hoglet67/Beeb1MHzBusFpga/kicad/v2/BusAdapter.pdf

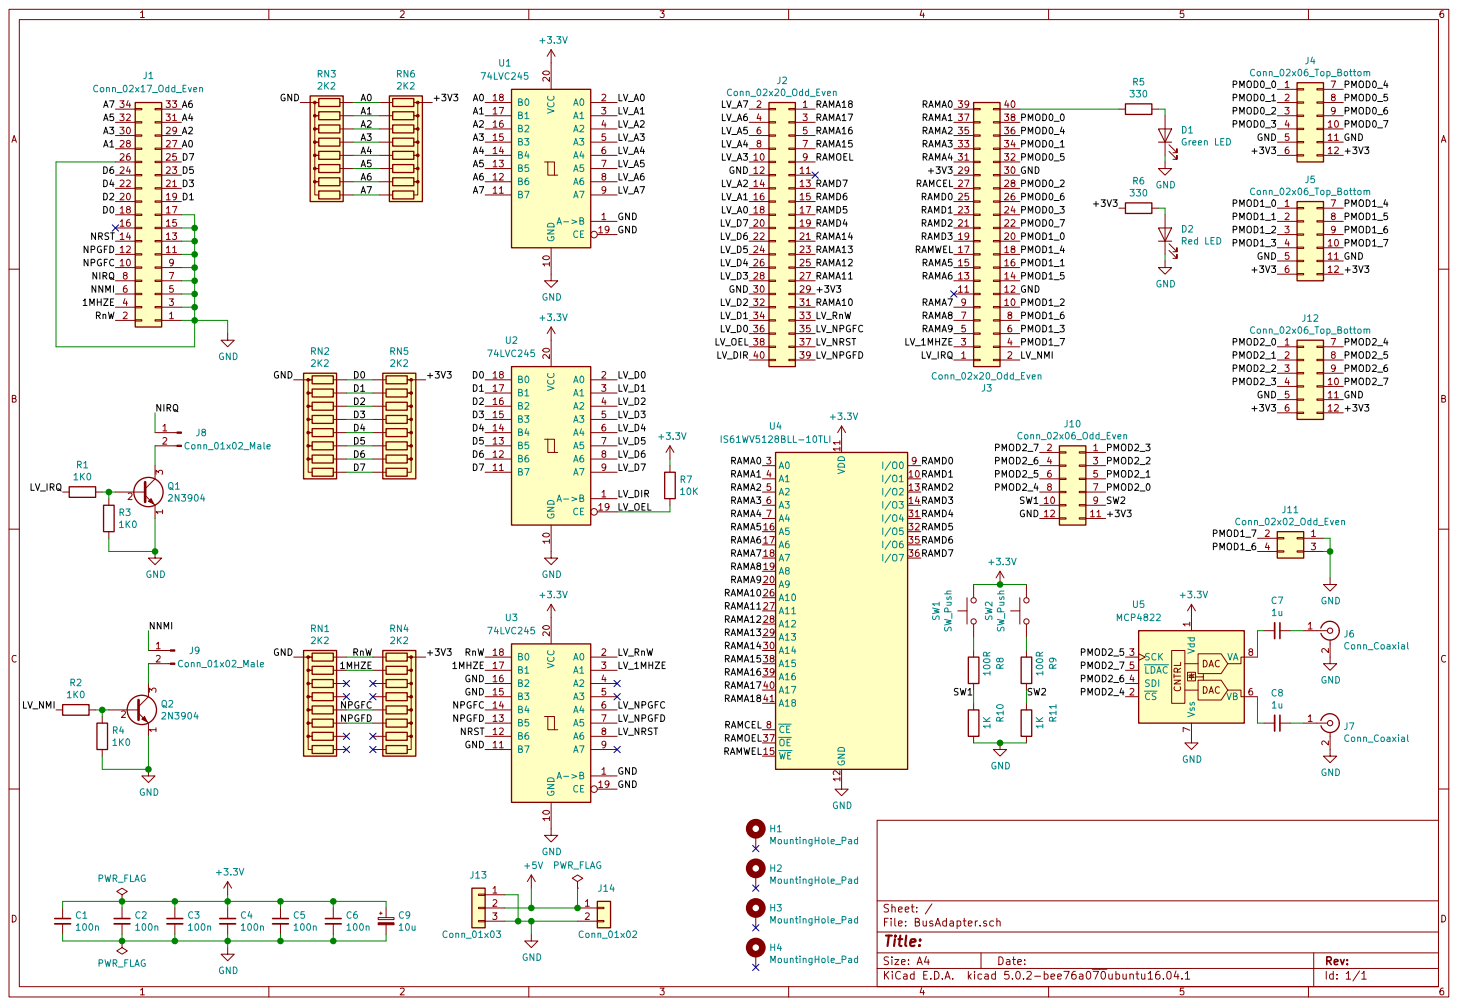
[picture p2: page 1]

File: BusAdapter.sch Sheet: /
Id: 1/1 Title:
