hoglet67/Beeb1MHzBusFpga/v1/Music5000.sch

## KiCad design v1/Music5000.sch (2019-03-05)

Schematic: Music5000.sch

Parts:
C1, C2, C3, C4, C5: 100n; C_Axial_L5.1mm_D3.1mm_P10.00mm_Horizontal
C6: 10u; CP_Radial_D5.0mm_P2.50mm
C7, C8: 1u; C_Rect_L7.2mm_W5.5mm_P5.00mm_FKS2_FKP2_MKS2_MKP2
D1, D2: LED; LED_D3.0mm
H1, H2, H3, H4: MountingHole_Pad; MountingHole_3.2mm_M3_Pad
J1: Conn_02x17_Odd_Even; IDC-Header_2x17_P2.54mm_Horizontal_Lock
J2, J3: Conn_02x20_Odd_Even; PinSocket_2x20_P2.54mm_Vertical
J4, J5: Conn_02x06_Top_Bottom; PinSocket_2x06_P2.54mm_Horizontal
J6, J7: Conn_Coaxial; phono
J8, J9: Conn_01x02_Male; PinHeader_1x02_P2.54mm_Vertical
Q1, Q2: 2N3904; TO-92_HandSolder
R1, R2, R3, R4, R8, R9: 1K0; R_Axial_DIN0207_L6.3mm_D2.5mm_P10.16mm_Horizontal
R5, R6: 330; R_Axial_DIN0207_L6.3mm_D2.5mm_P10.16mm_Horizontal
R7: 10K; R_Axial_DIN0207_L6.3mm_D2.5mm_P10.16mm_Horizontal
RN1, RN2, RN3, RN4, RN5, RN6: R_Network08; R_Array_SIP9
SW1, SW2: SW_Push; SW_PUSH_6mm_H5mm
U1, U2, U3: 74LVC245; DIP-20_W7.62mm_Socket
U4: IDT 71V424S12; SOJ-36_10.16x23.49mm_P1.27mm
U5: MCP4822; DIP-8_W7.62mm_Socket
