hoglet67/Beeb1MHzBusFpga/life/src/life.v

// The number of cascaded life pipeline stages. Above 8 stages there
// are issues on the vertical boundary because only column is prefetched
`ifndef STAGES
 `define STAGES          8
`endif

`define VERSION_MAJ 8'h00     // Major version is updated when ever there are incompatible register changes
`define VERSION_MIN 8'h00     // Minor version is updated when ever there are other changes

`define MAGIC_HI    8'h19     // Used to identify the presence of the hardware
`define MAGIC_LO    8'h67     // Used to identify the presence of the hardware

//`define VGA_800_600
//`define VGA_1024_768
//`define VGA_1280_720
//`define VGA_1280_768
//`define VGA_1280_1024
//`define VGA_1600_1200
//`define VGA_1920_1080
//`define VGA_1920_1200

// Default to 1600x1200 if nothing already specified
`ifndef VGA_800_600
 `ifndef VGA_1024_768
  `ifndef VGA_1280_720
   `ifndef VGA_1280_768
    `ifndef VGA_1280_1024
     `ifndef VGA_1600_1200
      `ifndef VGA_1920_1080
       `ifndef VGA_1920_1200
        `define VGA_1600_1200
       `endif
      `endif
     `endif
    `endif
   `endif
  `endif
 `endif
`endif

module life (
             // System oscillator
             clk50,
             // BBC 1MHZ Bus
             clke,
             rnw,
             rst_n,
             pgfc_n,
             pgfd_n,
             bus_addr,
             bus_data,
             bus_data_dir,
             bus_data_oel,
             nmi,
             irq,
             // RAM
             ram_addr,
             ram_data,
             ram_cel,
             ram_oel,
             ram_wel,
             // Misc
             pmod0,
             pmod1,
             pmod2,
             sw1,
             sw2,
             led
             );

   // System oscillator
   input             clk50;
   // BBC 1MHZ Bus
   input             clke;
   input             rnw;
   input             rst_n;
   input             pgfc_n;
   input             pgfd_n;
   input [7:0]       bus_addr;
   inout [7:0]       bus_data;
   output            bus_data_dir;
   output            bus_data_oel;
   output            nmi;
   output            irq;
   // RAM
   output reg [18:0] ram_addr;
   inout [7:0]       ram_data;
   output reg        ram_cel;
   output reg        ram_oel;
   output reg        ram_wel;
   // Misc
   output [7:0]      pmod0;
   output [7:0]      pmod1;
   inout  [7:0]      pmod2;
   input             sw1;
   input             sw2;
   output            led;

`include "resolutions.v"

   // Number of cascaded life pipeline stages
   localparam STAGES        = `STAGES;

   // Numver of address bits used for playfield pointers
   localparam ASIZE         = 19;

   // Number of rows in life playfield
   localparam NR            = V_ACTIVE;

   // Total number of rows on the display
   localparam TR            = V_TOTAL;

   // Number of (byte) cols in life playfield
   localparam NC            = H_ACTIVE / 8;

   // Total number of (byte) cols on the display
   localparam TC            = H_TOTAL / 8;

   // Video Pipeline Delay (inc SRAM) in clk_pixel cycles
   localparam VPD           = 2;

   // Scaler fractional bits
   localparam SFB           = 2;

   // Life Pipeline Delay (in bytes)
   localparam LPD           = 3;

   // Fixed point versions of H_ACTIVE and V_ACTIVE
   localparam H_ACTIVE_FP   = {H_ACTIVE, {SFB{1'b0}}};
   localparam V_ACTIVE_FP   = {V_ACTIVE, {SFB{1'b0}}};

   // Size of the BRAM used for the scaler (in units of 2 pixels)
   localparam BRAM_SIZE     = 262144;

   // Clocks
   wire                clk0;
   wire                clk1;
   wire                clk2;
   wire                locked1;
   wire                clk_pixel;
   wire                clk_pixel_n;

   // Video Timing
   reg [11:0]          h_counter_next = 0;
   reg [11:0]          h_counter = 0;
   reg [10:0]          v_counter_next = 0;
   reg [10:0]          v_counter = 0;
   reg                 last_vsync1 = 0;
   reg                 last_vsync2 = 0;
   reg                 active = 0;
   reg                 hsync = 0;
   reg                 vsync = 0;
   reg                 blank = 0;
   reg                 border = 0;
   reg [VPD:0]         hsync0 = 0; // +1 delay, to compensate for the DDR registers on RGB
   reg [VPD:0]         vsync0 = 0; // +1 delay, to compensate for the DDR registers on RGB
   reg [VPD-1:0]       blank0 = 0;
   reg [VPD-1:0]       border0 = 0;
   reg [7:0]           mask = 0;

   // RGB
   reg [11:0]          rgb0 = 0;
   reg [11:0]          rgb1 = 0;
   wire [11:0]         rgb;
   wire [3:0]          red;
   wire [3:0]          green;
   wire [3:0]          blue;

   // Scaler Registers
   reg [2:0]           scaler_zoom = 0;                    // 0 = fully zoomed out (scaler bypassed)
   reg [10+SFB:0]      scaler_x_origin = H_ACTIVE_FP / 2;  // 11.2 fixed point
   reg [10+SFB:0]      scaler_y_origin = V_ACTIVE_FP / 2;  // 11.2 fixed point
   wire [10+SFB:0]     scaler_x_next;                      // 11.2 fixed point
   wire [10+SFB:0]     scaler_y_next;                      // 11.2 fixed point
   reg [7:0]           scaler_x_speed = 0;                 // 6.2 fixed point
   reg [7:0]           scaler_y_speed = 0;                 // 6.2 fixed point

   // Scaler parameters
   reg [8:0]           scaler_w = 0;
   reg [9:0]           scaler_h = 0;
   reg [11:0]          scaler_x_lo_tmp = 0;
   reg [11:0]          scaler_x_hi_tmp = 0;
   reg [11:0]          scaler_y_lo_tmp = 0;
   reg [11:0]          scaler_x_lo = 0;
   reg [11:0]          scaler_x_hi = 0;
   reg [11:0]          scaler_y_lo = 0;
   reg [3:0]           scaler_inc_x_mask = 0;
   reg [3:0]           scaler_inc_y_mask = 1; // To prevent Xilinx warning
   reg [10:0]          scaler_y_offset = 0;

   // Scaler write pipeline
   reg                 active0 = 0;
   reg                 active1 = 0;
   reg                 active2 = 0;
   reg [9:0]           scaler_y_count0 = 0;
   reg                 scaler_rst0 = 0;
   reg                 scaler_rst1 = 0;
   reg                 scaler_x_in_range0 = 0;
   reg                 scaler_wr1 = 0;
   reg                 scaler_wr2 = 0;
   reg                 scaler_wr3 = 0;
   reg [1:0]           scaler_bdr0 = 0;
   reg [1:0]           scaler_bdr1 = 0;
   reg [1:0]           scaler_bdr2 = 0;
   reg [1:0]           scaler_odd_din3 = 0;
   reg [1:0]           scaler_eve_din3 = 0;

   reg [8:0]           scaler_wr_addr_x2 = 0;
   reg [17:0]          scaler_wr_addr_y2 = 0;
   reg [17:0]          scaler_wr_addr3 = 0;
   reg                 scaler_din_last = 0;

   // Scaler RAM
   reg [1:0]           scaler_ram[0:BRAM_SIZE - 1];
   reg                 scaler_bank = 0;

   // Scaler read pipeline
   reg [17:0]          scaler_rd_addr_x = 0;
   reg [17:0]          scaler_rd_addr_y = 0;
   reg [17:0]          scaler_rd_addr = 0;
   reg                 scaler_rd_rst_x = 0;
   reg                 scaler_rd_rst_y = 0;
   reg                 scaler_rd_inc_x = 0;
   reg                 scaler_rd_inc_y = 0;
   reg                 scaler_rd_active = 0;
   reg                 scaler_pix_sel0 = 0;
   reg                 scaler_pix_sel1 = 0;
   reg [1:0]           scaler_dout2 = 0;
   reg                 scaler_dout = 0;

   // Life Pipeline
   reg                 life_clken = 0;
   reg                 life_rd_active = 0;
   wire [ASIZE-1:0]    life_rd_addr;
   reg [7:0]           life_rd_data = 0;
   reg                 life_wr_active = 0;
   reg [ASIZE-1:0]     life_wr_addr = 0;
   wire [7:0]          life_wr_data;
   reg [ASIZE-1:0]     life_col_addr = 0;
   reg [ASIZE-1:0]     life_row_addr = 0;
   reg [7:0]           display_dout = 0;
   reg                 running = 0;
   reg                 life_bank = 0;

   // Memory Controller
   reg                 beeb_rd = 0;
   reg                 write_n = 0;
   reg [7:0]           ram_din = 0;

   // 1MHz Bus
   reg                 selected = 0;
   reg                 selected_rr = 0;
   wire                selected_reg = selected && !selected_rr;
   wire                selected_ram = selected &&  selected_rr;

   reg [ASIZE-1:0]     cpu_addr = 0;
   reg [7:0]           cpu_wr_data = 0;
   reg                 cpu_wr_pending = 0;
   reg                 cpu_wr_pending1 = 0;
   reg                 cpu_wr_pending2 = 0;
   reg [7:0]           cpu_rd_data = 0;
   reg                 cpu_rd_pending = 0;
   reg                 cpu_rd_pending1 = 0;
   reg                 cpu_rd_pending2 = 0;
   reg [7:0]           control = 8'h00;

   wire                ctrl_running     = control[7];
   wire                ctrl_mask        = control[6];
   wire                ctrl_clear       = control[5];
   wire                ctrl_border      = control[4];
   wire [1:0]          ctrl_clear_type  = control[1:0];

   reg [3:0]           ctrl_stage_enabled = 0;
   reg [4:0]           speed_bin = 0;
   reg [STAGES-1:1]    stage_enabled = 0;

   wire [7:0]          status = { running, vsync, 2'b00, ctrl_stage_enabled};

   wire [7:0]          width_div_8 = H_ACTIVE / 8;
   wire [7:0]          height_div_8 = V_ACTIVE / 8;

   reg [7:0]           clear_wr_data = 0;
   reg [30:0]          prbs0 = 31'h12345678; // pick different seeds at random
   reg [30:0]          prbs1 = 31'h49987ffe;
   reg [30:0]          prbs2 = 31'h2fe457aa;

   genvar              i;
   integer             s;

   reg [7:0]           cells8;
   reg [31:0]          cells_tmp;
   reg [31:0]          cells;
   reg [31:0]          gens;

   function [7:0] to_byte(input [31:0] i);
      to_byte = i[7:0];
   endfunction

   function [ASIZE-1:0] truncate_address(input [ASIZE:0] addr);
      truncate_address = addr[ASIZE-1:0];
   endfunction

   function [ASIZE-1:0] double_buffer_address(input bank, input [ASIZE-1:0] addr);
      // double buffer the first 1/16th of the RAM
      if (addr[ASIZE-1:ASIZE-4] == 0)
        double_buffer_address = {{4{bank}}, addr[ASIZE-5:0]};
      else
        double_buffer_address = addr;
   endfunction

   function [3:0] count_live_cells(input [7:0] d);
      count_live_cells = d[0] + d[1] + d[2] + d[3] + d[4] + d[5] + d[6] + d[7];
   endfunction

   // =================================================
   // Clock Generation
   // =================================================

   generate

      if (DCM_M2 > 0) begin
         DCM
           #(
             .CLKFX_MULTIPLY   (DCM_M),
             .CLKFX_DIVIDE     (DCM_D),
             .CLKIN_PERIOD     (20.000),
             .CLK_FEEDBACK     ("1X")
             )
         DCM1
           (
            .CLKIN            (clk50),
            .CLKFB            (clk0),
            .RST              (1'b0),
            .DSSEN            (1'b0),
            .PSINCDEC         (1'b0),
            .PSEN             (1'b0),
            .PSCLK            (1'b0),
            .CLKFX            (clk1),
            .CLKFX180         (),
            .CLKDV            (),
            .CLK2X            (),
            .CLK2X180         (),
            .CLK0             (clk0),
            .CLK90            (),
            .CLK180           (),
            .CLK270           (),
            .LOCKED           (locked1),
            .PSDONE           (),
            .STATUS           ()
            );

         DCM
           #(
             .CLKFX_MULTIPLY   (DCM_M2),
             .CLKFX_DIVIDE     (DCM_D2),
             .CLK_FEEDBACK     ("1X")
             )
         DCM2
           (
            .CLKIN            (clk1),
            .CLKFB            (clk2),
            .RST              (!locked1),
            .DSSEN            (1'b0),
            .PSINCDEC         (1'b0),
            .PSEN             (1'b0),
            .PSCLK            (1'b0),
            .CLKFX            (clk_pixel),
            .CLKFX180         (clk_pixel_n),
            .CLKDV            (),
            .CLK2X            (),
            .CLK2X180         (),
            .CLK0             (clk2),
            .CLK90            (),
            .CLK180           (),
            .CLK270           (),
            .LOCKED           (),
            .PSDONE           (),
            .STATUS           ()
            );

      end else begin

         DCM
           #(
             .CLKFX_MULTIPLY   (DCM_M),
             .CLKFX_DIVIDE     (DCM_D),
             .CLKIN_PERIOD     (20.000),
             .CLK_FEEDBACK     ("1X")
             )
         DCM1
           (
            .CLKIN            (clk50),
            .CLKFB            (clk0),
            .RST              (1'b0),
            .DSSEN            (1'b0),
            .PSINCDEC         (1'b0),
            .PSEN             (1'b0),
            .PSCLK            (1'b0),
            .CLKFX            (clk_pixel),
            .CLKFX180         (clk_pixel_n),
            .CLKDV            (),
            .CLK2X            (),
            .CLK2X180         (),
            .CLK0             (clk0),
            .CLK90            (),
            .CLK180           (),
            .CLK270           (),
            .LOCKED           (),
            .PSDONE           (),
            .STATUS           ()
            );

      end

   endgenerate

   // =================================================
   // Video Timing
   // =================================================

   always @(h_counter or v_counter) begin
      if (h_counter == H_TOTAL - 2) begin
         h_counter_next = 0;
         if (v_counter == V_TOTAL - 1)
           v_counter_next = 0;
         else
           v_counter_next = v_counter + 1'b1;
      end else begin
         v_counter_next = v_counter;
         // Step the h_counter in units of two pixels
         // (this means the LSB is not used, and will likely generate a warning)
         h_counter_next = h_counter + 2'b10;
      end
   end


   always @(posedge clk_pixel) begin
      h_counter <= h_counter_next;
      v_counter <= v_counter_next;

      // Active lags h_counter by one cycle
      active    <= h_counter_next < H_ACTIVE && v_counter_next < V_ACTIVE;

      // Skew the video control outputs by VPD clocks to compensate for the video pipeline delay
      // (the other way of doing this would be with pipeline registers)
      { hsync,  hsync0} <= {hsync0, (h_counter >= H_SYNC_START && h_counter < H_SYNC_END)};
      { vsync,  vsync0} <= {vsync0, (v_counter >= V_SYNC_START && v_counter < V_SYNC_END)};
      { blank,  blank0} <= {blank0, (h_counter >= H_ACTIVE || v_counter >= V_ACTIVE)};
      {border, border0} <= {border0, ((h_counter == 0 || h_counter == H_ACTIVE - 2) && (v_counter < V_ACTIVE)) ||
                                     ((v_counter == 0 || v_counter == V_ACTIVE - 1) && (h_counter < H_ACTIVE))};
   end

   // =================================================
   // Scaler (TODO: make this a seperate module)
   // =================================================


   always @(posedge clk_pixel) begin

      // No attempt had been made to control the latency through the scaler
      // so it's possible that the window will be a few pixels out horizonal in absolute accuracy

      // Example at 1600x1200:
      // Zoom = 0; window is 1600x1200 pixels (scaler bypassed)
      // Zoom = 1; window is 800x600 pixels
      // Zoom = 2; window is 400x300 pixels
      // Zoom = 3; window is 200x150 pixels
      // Zoom = 4; window is 100x75 pixels

      // *************************************************************************
      // *** Parameters (depend only on registers, so are considered fixed)
      // *************************************************************************

      case (scaler_zoom)
        3'b100:
          begin
             scaler_w <= H_ACTIVE / 32; // units of two-pixels
             scaler_h <= V_ACTIVE / 16;
             scaler_inc_x_mask <= 4'b1110;
             scaler_inc_y_mask <= 4'b1111;
             scaler_y_offset   <= 0;
          end
        3'b011:
          begin
             scaler_w <= H_ACTIVE / 16; // units of two-pixels
             scaler_h <= V_ACTIVE / 8;
             scaler_inc_x_mask <= 4'b0110;
             scaler_inc_y_mask <= 4'b0111;
             scaler_y_offset   <= 0;
          end
        3'b010:
          begin
             scaler_w <= H_ACTIVE / 8;  // units of two-pixels
             scaler_h <= V_ACTIVE / 4;
             scaler_inc_x_mask <= 4'b0010;
             scaler_inc_y_mask <= 4'b0011;
             scaler_y_offset   <= 0;
          end
        default:
          begin
             scaler_w <= H_ACTIVE / 4;  // units of two-pixels
             scaler_inc_x_mask <= 4'b0000;
             scaler_inc_y_mask <= 4'b0001;
             // At 1920x1200 this we need to reduce the number of active lines as there is insufficient RAM
             if (V_ACTIVE * H_ACTIVE / 8 < BRAM_SIZE) begin
               scaler_h <= V_ACTIVE / 2;
               scaler_y_offset <= 0;
             end else begin
               scaler_h <= BRAM_SIZE / (H_ACTIVE / 4);                          // 546 (rather than 600)
               scaler_y_offset <= (V_ACTIVE / 2) - BRAM_SIZE / (H_ACTIVE / 4);  // 54
             end
          end
      endcase

      // Calculate x,y of top left corner (only allow changes when scaler not running)
      if (scaler_y_count0 == 0) begin
         // Ignore the fractional bits
         scaler_x_lo_tmp <= scaler_x_origin[10+SFB:SFB] - scaler_w;
         scaler_x_hi_tmp <= scaler_x_origin[10+SFB:SFB] + scaler_w;
         scaler_y_lo_tmp <= scaler_y_origin[10+SFB:SFB] - scaler_h[9:1];
      end

      // Correct for wrapping
      if (scaler_x_lo_tmp < H_ACTIVE)
        scaler_x_lo <= scaler_x_lo_tmp;
      else
        scaler_x_lo <= scaler_x_lo_tmp + H_ACTIVE;
      if (scaler_x_hi_tmp <= H_ACTIVE)
        scaler_x_hi <= scaler_x_hi_tmp;
      else
        scaler_x_hi <= scaler_x_hi_tmp - H_ACTIVE;
      if (scaler_y_lo_tmp < V_ACTIVE)
        scaler_y_lo <= scaler_y_lo_tmp;
      else
        scaler_y_lo <= scaler_y_lo_tmp + V_ACTIVE;

      // *************************************************************************
      // *** Write Pipeline stage 0 (only this stage uses h_counter/v_counter and active)
      // *************************************************************************

      // Double buffer bank selection
      if (h_counter == 0 && v_counter == 0) begin
        if (scaler_zoom < 3'b010) begin
          scaler_bank <= 1'b0;
        end else begin
          scaler_bank <= !scaler_bank;
        end
      end

      // When to start capturing
      scaler_rst0 <= 1'b0;
      if (active) begin
         if (scaler_x_lo < scaler_x_hi) begin
            // The window doesn't cross the L/R boundary
            if (h_counter == {1'b0, scaler_x_lo[10:1], 1'b0}) begin
               if (v_counter == scaler_y_lo[10:0]) begin
                  scaler_rst0 <= 1'b1;
                  scaler_y_count0 <= scaler_h;
               end else if (|scaler_y_count0) begin
                  scaler_y_count0 <= scaler_y_count0 - 1'b1;
               end
            end
         end else begin
            if (h_counter == 0) begin
               if (v_counter == scaler_y_lo[10:0]) begin
                  scaler_rst0 <= 1'b1;
                  scaler_y_count0 <= scaler_h;
               end else if (|scaler_y_count0) begin
                  scaler_y_count0 <= scaler_y_count0 - 1'b1;
               end
            end
         end
      end

      if (scaler_x_lo < scaler_x_hi) begin
         scaler_x_in_range0 <= (h_counter >= {1'b0, scaler_x_lo[10:1], 1'b0}) && (h_counter < {1'b0, scaler_x_hi[10:1], 1'b0});
      end else begin
         scaler_x_in_range0 <= (h_counter >= {1'b0, scaler_x_lo[10:1], 1'b0}) || (h_counter < {1'b0, scaler_x_hi[10:1], 1'b0});
      end

      scaler_bdr0 <= (v_counter == 0 || v_counter == V_ACTIVE - 1) ? {2{ctrl_border}} : 2'b00;
      active0     <= active;

      // *************************************************************************
      // *** Write Pipeline stage 1, uses outputs of stage 0
      // *************************************************************************

      scaler_wr1  <= scaler_x_in_range0 && |scaler_y_count0 && active0;
      scaler_rst1 <= scaler_rst0;
      scaler_bdr1 <= scaler_bdr0;
      active1     <= active0;

      // *************************************************************************
      // *** Write Pipeline stage 2, uses outputs of stage 1
      // *************************************************************************

      // Scaler write address
      if (scaler_x_lo < scaler_x_hi) begin
         // The window doesn't cross the L/R boundary
         if (scaler_rst1) begin
            scaler_wr_addr_x2 <= 0;
            scaler_wr_addr_y2 <= {scaler_bank, 17'b0};
         end else if (scaler_wr1) begin
            if (scaler_wr_addr_x2 >= scaler_w - 1'b1) begin
               scaler_wr_addr_x2 <= 0;
            end else begin
               scaler_wr_addr_x2 <= scaler_wr_addr_x2 + 1'b1;
            end
            if (scaler_wr_addr_x2 + 1'b1 == scaler_w) begin
               scaler_wr_addr_y2 <= scaler_wr_addr_y2 + scaler_w;
            end
         end
      end else begin
         // The window crosses the L/R boundary
         if (scaler_rst1) begin
            scaler_wr_addr_x2 <= scaler_w - scaler_x_hi[9:1];
            scaler_wr_addr_y2 <= {scaler_bank, 17'b0};
         end else if (scaler_wr1) begin
            if (scaler_wr_addr_x2 >= scaler_w - 1'b1) begin
               scaler_wr_addr_x2 <= 0;
            end else begin
               scaler_wr_addr_x2 <= scaler_wr_addr_x2 + 1'b1;
            end
            if (scaler_wr_addr_x2 + 1'b1 == scaler_w - scaler_x_hi[10:1]) begin
               scaler_wr_addr_y2 <= scaler_wr_addr_y2 + scaler_w;
            end
         end
      end

      // Add in the the L/R boundart
      if (scaler_x_lo[0]) begin
         if (active1 && !active2)
           scaler_bdr2 <= scaler_bdr1 | {ctrl_border, 1'b0};
         else if (active1 && !active0)
           scaler_bdr2 <= scaler_bdr1 | {1'b0, ctrl_border};
         else
           scaler_bdr2 <= scaler_bdr1;
      end else begin
         if (active1 && !active2)
           scaler_bdr2 <= scaler_bdr1 | {2{ctrl_border}};
         else
           scaler_bdr2 <= scaler_bdr1;
      end

      scaler_wr2  <= scaler_wr1;
      active2     <= active1;

      // *************************************************************************
      // *** Write Pipeline stage 3, uses outputs of stage 2
      // *************************************************************************

      // Capture the right pixel in the previous sample. This happens to work correctly
      // even at the wrap point, because extras reads of the last/first columns are
      // inserted before/after the active line so the life engine works properly.
      scaler_din_last <= display_dout[6];

      // At odd pixel offets, the two output pixels need to be taken from adjacent samples
      scaler_odd_din3 <= {scaler_din_last, display_dout[7]} | scaler_bdr2;

      // At even pixel offsets, the two output pixels in the display sample are correctly aligned
      scaler_eve_din3 <= display_dout[7:6] | scaler_bdr2;

      scaler_wr_addr3 <= scaler_wr_addr_y2 + scaler_wr_addr_x2;
      scaler_wr3      <= scaler_wr2;

      // *************************************************************************
      // *** Scaler RAM Write
      // *************************************************************************
      if (scaler_wr3)
        scaler_ram[scaler_wr_addr3] <= scaler_x_lo[0] ? scaler_eve_din3 : scaler_odd_din3;

      // *************************************************************************
      // *** Scaler Read Pipelie
      // *************************************************************************

      // When to reset the scaler rd address
      scaler_rd_rst_x <= h_counter == H_ACTIVE;
      scaler_rd_rst_y <= v_counter == (scaler_y_offset > 0 ? scaler_y_offset - 1 : V_TOTAL - 1);

      // When to increment the scaler rd addess
      scaler_rd_inc_x <= ((h_counter[3:0] & scaler_inc_x_mask) == scaler_inc_x_mask) && active;
      scaler_rd_inc_y <= ((v_counter[3:0] & scaler_inc_y_mask) == scaler_inc_y_mask) && h_counter == H_ACTIVE;

      // X component of scaler read address (bit 0 of this selects the one of the pixel pair)
      if (scaler_rd_rst_x)
        scaler_rd_addr_x <= 0;
      else if (scaler_rd_inc_x)
        scaler_rd_addr_x <= scaler_rd_addr_x + 1'b1;

      // Y component of scaler read address
      // (this happens at the end of the frame, so bank is the bank that has just been written)
      if (scaler_rd_rst_y)
        scaler_rd_addr_y <= {scaler_bank, 17'h00000};
      else if (scaler_rd_inc_y)
        scaler_rd_addr_y <= scaler_rd_addr_y + scaler_w;

      // Scaler read address
      scaler_rd_addr  <= scaler_rd_addr_x[17:1] + scaler_rd_addr_y;
      scaler_pix_sel0 <= scaler_rd_addr_x[0];

      // Scaler read
      scaler_dout2    <= scaler_ram[scaler_rd_addr];
      scaler_pix_sel1 <= scaler_pix_sel0;

      if (v_counter >= scaler_y_offset && v_counter < V_ACTIVE - scaler_y_offset)
        // Output of the scaler is a single pixel
        scaler_dout <= scaler_pix_sel1 ? scaler_dout2[0] : scaler_dout2[1];
      else
        // If the view is truncated vertically, mask on inactive lines
        scaler_dout <= 1'b0;

   end

   // =================================================
   // Pixel Output
   // =================================================

   wire rescale = |scaler_zoom;

   always @(negedge clk_pixel) begin
      if ((!blank) && (rescale ? scaler_dout : display_dout[7])) begin
         rgb1 <= 12'hFFF;
      end else if (border) begin
         if (ctrl_mask)
           rgb1 <= 12'hF00;
         else
           rgb1 <= 12'h0F0;
      end else begin
         rgb1 <= 12'h000;
      end
      if ((!blank) && (rescale ? scaler_dout : display_dout[6])) begin
         rgb0 <= 12'hFFF;
      end else if (border) begin
         if (ctrl_mask)
           rgb0 <= 12'hF00;
         else
           rgb0 <= 12'h0F0;
      end else begin
         rgb0 <= 12'h000;
      end
   end

   // Use ODDR2 registers to output pixels at 2x clk_pixel
   generate
      for (i = 0; i < 12; i = i + 1) begin : b_rgb
        ODDR2 oddr2_rgb (
                   .Q  (rgb[i]),
                   .C0 (clk_pixel_n),
                   .C1 (clk_pixel),
                   .CE (1'b1),
                   .D0 (rgb0[i]),
                   .D1 (rgb1[i]),
                   .R  (1'b0),
                   .S  (1'b0)
                );
      end
   endgenerate

   assign red   = rgb[11:8];
   assign green = rgb[ 7:4];
   assign blue  = rgb[ 3:0];


   // =================================================
   // Life Pipeline
   // =================================================

   wire [STAGES*8-1:0] stage;
   generate
      for (i = 0; i < STAGES; i = i + 1) begin : b_life
         life_pipeline #(NC + LPD * STAGES + 1) lp
               (.clk       (clk_pixel),
                .clken     (life_clken),
                .enabled   ((i == 0) ? 1'b1         : stage_enabled[i]),
                .read_data ((i == 0) ? life_rd_data : stage[(i-1)*8+7:(i-1)*8]),
                .write_data(stage[i*8+7:i*8]));
      end
   endgenerate
   assign life_wr_data = stage[STAGES*8-1:STAGES*8-8];

   // =================================================
   // Life Address Generation
   // =================================================

   assign life_rd_addr = life_row_addr + life_col_addr;

   always @(posedge clk_pixel) begin

      // life_rd_addr = 0 (Row0, Col0) needs to coincide with h/v_counter = 0
      //
      // NR is the number of active rows (same as V_ACTIVE)
      // NC is the number of active cols (same as H_ACTIVE / 8)
      // S  is the number of pipeline stages
      //
      // At the end of the frame, we preload the pipeline with S rows. This has
      // the miraculous effect of fixing the top/bottom boundary discontinuity
      // that would otherwise mess up the multi-stage implementaton. I haven't
      // yet fully understood why this works!
      //
      // Row sequence is NR+S+1:
      //    0, 1, 2, ..., NR-1, 0, <idle during vsync>, NR-S, NR-S+1, ... NR-1
      // (i.e. the first and last S rows are read twice)
      //
      // Col sequence is NC+2:
      //    0, 1, 2, ..., NC-1, 0, <idle during hsync>, NC-1
      // (i.e. the first and last cols are read twice)
      //

      // Life memory reads are active for NC+2 cols and NR+2 rows compared to the video; pipeline now clocked on this as well
      life_rd_active <= (h_counter_next[11:3] < (NC + LPD * STAGES) || h_counter_next[11:3] == (TC - 1)) && (v_counter_next < (NR + STAGES) || v_counter_next > (TR - 2 - STAGES));

      // Life memory writes are active for NC cols and NR rows, but skewed by a couple of cycles
      life_wr_active <= (h_counter_next[11:3] >= (LPD * STAGES)) && (h_counter_next[11:3] < (NC + LPD * STAGES)) && (v_counter_next >= STAGES) && (v_counter_next < (NR + STAGES));

      // Increment on the 11 cycle, so address stable when next memory cycle starts
      if (h_counter[2:1] == 2'b11) begin
         // Generate the column part of the address
         if (h_counter[11:3] == TC - 2)
           life_col_addr <= NC - 1;
         else if (life_col_addr == NC - 1)
           life_col_addr <= 0;
         else
           life_col_addr <= life_col_addr + 1'b1;
         // Generate the row part of the address
         if (h_counter[11:3] == TC - 2)
           if (v_counter == TR - 2 - STAGES)
             life_row_addr <= (NR - STAGES - 1) * NC;
           else if (life_row_addr == (NR - 1) * NC)
             life_row_addr <= 0;
           else
             life_row_addr <= truncate_address(life_row_addr + NC);
      end

      // Increment on the 11 cycle, so address stable when next memory cycle starts
      if (h_counter[2:1] == 2'b01) begin
         if (life_wr_active) begin
            // The patter of write addresses is simply sequential
            if (v_counter == STAGES && h_counter[11:3] == LPD * STAGES)
                life_wr_addr <= 0;
              else
                life_wr_addr <= life_wr_addr + 1'b1;
         end
      end

      // Life pipeline clocked for just one cycle out of four
      life_clken <= (h_counter[2:1] == 2'b10) && life_rd_active;

      // Just after the last row of writes is a safe place to
      if (h_counter[2:1] == 2'b11 && h_counter[11:3] == NC + LPD * STAGES && v_counter == NR + STAGES - 1) begin
         // Switch to view bank just written, if we are running
         if (running)
           life_bank <= !life_bank;
         // Update running from the register
         running <= ctrl_running;
         // Update the stage enabled bits
         for (s = 1; s < STAGES; s = s + 1)
           stage_enabled[s] <= (ctrl_stage_enabled >= s);
         speed_bin <= ctrl_stage_enabled + 4'b1;
         // Update stats
         cells_tmp <= 0;
         cells     <= cells_tmp;
         if (ctrl_clear)
           gens <= 0;
         else if (running)
           gens <= gens + speed_bin;
      end

      if (active && h_counter[2:1] == 2'b11)
        cells_tmp <= cells_tmp + count_live_cells(cells8);

   end

   // =================================================
   // RAM Address / Control Generation
   // =================================================

   always @(posedge clk_pixel) begin

      // Synchronize the RD/WR Pending signals from the 1MHz Domain
      if (h_counter[2:1] == 2'b01) begin
         cpu_rd_pending1 <= cpu_rd_pending;
         cpu_wr_pending1 <= cpu_wr_pending;
      end

      // --------------------------------------------------
      // Memory Cycle 1
      //     h_counter == 2'b00 and 2'b01
      //
      // used for:
      //     life (i.e. display) reads
      // --------------------------------------------------

      if (h_counter[2:1] == 2'b00) begin
         if (life_rd_active) begin
            // Start Life Engine Read Cycle
            ram_cel  <= 1'b0;
            ram_oel  <= 1'b0;
            write_n  <= 1'b1;
            ram_addr <= double_buffer_address(life_bank, life_rd_addr);
         end else begin
            // Idle Cycle
            ram_cel  <= 1'b1;
            ram_oel  <= 1'b1;
            write_n  <= 1'b1;
            ram_addr <= 19'h7FFFF;
         end
      end

      if (life_rd_active) begin
         if (h_counter[2:1] == 2'b10) begin
            // Capture Data from Life Read Cycle for life engine (during active part of line active)
            life_rd_data <= ram_data;
         end
      end

      if (h_counter[2:1] == 2'b10) begin
         // Capture Data from Life Read Cycle for display
         display_dout <= ram_data;
         // Take a copy for counting
         cells8 <= ram_data;
      end else begin
         // Shift two pixels regardless, this avoids right column display artifacts
         display_dout <= {display_dout[5:0], 2'b0};
      end

      // Compute the mask for the next write cycle (to prevent wrapping)
      //  (v_counter is 1 line ahead of the write address)
      //  (h_counter is 2 bytes ahead of the write address)
      if (h_counter[2:1] == 2'b01) begin
         if (ctrl_mask && v_counter == STAGES)
           // Top
           mask <= 8'h00;
         else if (ctrl_mask && v_counter == STAGES - 1)
           // Bottom
           mask <= 8'h00;
         else if (ctrl_mask && h_counter[11:3] == STAGES * LPD)
           // Left
           mask <= 8'h7f;
         else if (ctrl_mask && h_counter[11:3] == STAGES * LPD - 1)
           // Right
           mask <= 8'hfe;
         else
           // No masking
           mask <= 8'hff;
      end

      // --------------------------------------------------
      // Memory Cycle 2
      //     h_counter == 2'b10 and 2'b11
      //
      // used for:
      //     life writes (highest priority)
      //     beeb reads
      //     beeb writes (lowest priority)
      // --------------------------------------------------

      if (h_counter[2:1] == 2'b10) begin
         beeb_rd <= 1'b0;
         if (life_wr_active && running) begin
            // Start Life Engine Write Cyle
            ram_cel  <= 1'b0;
            ram_oel  <= 1'b1;
            ram_addr <= double_buffer_address(!life_bank, life_wr_addr);
            ram_din  <= ctrl_clear ? clear_wr_data : (life_wr_data & mask);
            write_n  <= 1'b0;
         end else if (cpu_rd_pending2 != cpu_rd_pending1) begin
            // Start Beeb Read Cyle
            ram_cel  <= 1'b0;
            ram_oel  <= 1'b0;
            ram_addr <= double_buffer_address(life_bank, cpu_addr);
            write_n  <= 1'b1;
            cpu_rd_pending2 <= cpu_rd_pending1;
            beeb_rd  <= 1'b1; // delay reading of beeb data a cycle
         end else if (cpu_wr_pending2 != cpu_wr_pending1) begin
            // Start Beeb Write Cyle
            ram_cel  <= 1'b0;
            ram_oel  <= 1'b1;
            ram_addr <= double_buffer_address(life_bank, cpu_addr);
            ram_din  <= cpu_wr_data;
            write_n  <= 1'b0;
            cpu_wr_pending2 <= cpu_wr_pending1;
         end else begin
            // Idle Cycle
            ram_cel  <= 1'b1;
            ram_oel  <= 1'b1;
            write_n  <= 1'b1;
            ram_addr <= 19'h7FFFF;
         end
      end

      // Capture Data from Beeb Read Cycle
      if (h_counter[2:1] == 2'b00 && beeb_rd) begin
         beeb_rd     <= 1'b0;
         cpu_rd_data <= ram_data;
      end

      // In all cases, de-assert write in the second half of the write cycle
      if (h_counter[2:1] == 2'b11) begin
         write_n <= 1'b1;
      end

   end

   // Actual write strobe is skewed by half a clock, so it is in the middle of the pair of cycles
   always @(negedge clk_pixel) begin
      ram_wel = write_n;
   end

   // Only drive the ram data bus when ram_wel is asserted
   assign ram_data = ram_wel ? 8'hZZ : ram_din;

   // =================================================
   // Data generator for clearing
   // =================================================

   always @(posedge clk_pixel) begin
      case (ctrl_clear_type)
        2'b01:
          clear_wr_data <= prbs0[7:0] & prbs1[7:0] & prbs2[7:0];
        2'b10:
          clear_wr_data <= prbs0[7:0] & prbs1[7:0];
        2'b11:
          clear_wr_data <= prbs0[7:0];
        default:
          clear_wr_data <= 8'h00;
      endcase
      // Generate two bits at a time
      prbs0 <= {prbs0[28:0], prbs0[27] ^ prbs0[30], prbs0[26] ^ prbs0[29]};
      prbs1 <= {prbs1[28:0], prbs1[27] ^ prbs1[30], prbs1[26] ^ prbs1[29]};
      prbs2 <= {prbs2[28:0], prbs2[27] ^ prbs2[30], prbs2[26] ^ prbs2[29]};
   end

   // =================================================
   // 1MHz Bus Interface
   // =================================================

   assign scaler_x_next = scaler_x_origin + {{(3+SFB){scaler_x_speed[7]}}, scaler_x_speed};
   assign scaler_y_next = scaler_y_origin + {{(3+SFB){scaler_y_speed[7]}}, scaler_y_speed};

   always @(negedge clke) begin
      if (!rst_n) begin
         selected    <= 1'b0;
         selected_rr <= 1'b0;
      end else begin
         // Page FC registers
         if (!pgfc_n && bus_addr == 8'hFF && !rnw) begin
            if (bus_data == 8'hC8)
              selected <= 1'b1;
            else
              selected <= 1'b0;
         end
         if (!pgfc_n && selected && bus_addr == 8'hFE && !rnw) begin
            cpu_addr[ASIZE-1:16] <= bus_data[ASIZE-17:0];
            selected_rr <= bus_data[7];
         end
         if (!pgfc_n && selected && bus_addr == 8'hFD && !rnw) begin
           cpu_addr[15:8] <= bus_data;
         end
         // Page FD registers
         if (!pgfd_n && selected_reg && bus_addr == 8'h00 && !rnw)
           control <= bus_data;
         if (!pgfd_n && selected_reg && bus_addr == 8'h01 && !rnw)
           ctrl_stage_enabled <= bus_data[3:0];
         if (!pgfd_n && selected_reg && bus_addr == 8'h04 && !rnw)
           scaler_x_origin[7:0] <= bus_data;
         if (!pgfd_n && selected_reg && bus_addr == 8'h05 && !rnw)
           scaler_x_origin[10+SFB:8] <= bus_data[2+SFB:0];
         if (!pgfd_n && selected_reg && bus_addr == 8'h06 && !rnw)
           scaler_y_origin[7:0] <= bus_data;
         if (!pgfd_n && selected_reg && bus_addr == 8'h07 && !rnw)
           scaler_y_origin[10+SFB:8] <= bus_data[2+SFB:0];
         if (!pgfd_n && selected_reg && bus_addr == 8'h08 && !rnw)
           scaler_zoom <= bus_data[2:0];
         if (!pgfd_n && selected_reg && bus_addr == 8'h09 && !rnw)
           scaler_x_speed <= bus_data;
         if (!pgfd_n && selected_reg && bus_addr == 8'h0A && !rnw)
           scaler_y_speed <= bus_data;
         if (selected_ram && !pgfd_n && !rnw) begin
            cpu_wr_pending <= !cpu_wr_pending;
            cpu_wr_data <= bus_data;
         end
         last_vsync1 <= vsync;
         last_vsync2 <= last_vsync1;
         if (last_vsync1 && !last_vsync2) begin
            // Auto-pan scaler_x_origin, correctly wrapping
            if (scaler_x_next < H_ACTIVE_FP)
              scaler_x_origin <= scaler_x_next;
            else if (scaler_x_speed[7])
              scaler_x_origin <= scaler_x_next + H_ACTIVE_FP;
            else
              scaler_x_origin <= scaler_x_next - H_ACTIVE_FP;
            // Auto-pan scaler_y_origin, correctly wrapping
            if (scaler_y_next < V_ACTIVE_FP)
              scaler_y_origin <= scaler_y_next;
            else if (scaler_y_speed[7])
              scaler_y_origin <= scaler_y_next + V_ACTIVE_FP;
            else
              scaler_y_origin <= scaler_y_next - V_ACTIVE_FP;
         end
      end
   end

   always @(posedge clke) begin
      if (selected_ram && !pgfd_n)
        cpu_addr[7:0] <= bus_addr;
      if (selected_ram && !pgfd_n && rnw)
        cpu_rd_pending <= !cpu_rd_pending;
   end

   assign bus_data = (!pgfd_n && selected_reg && bus_addr == 8'h00 && rnw) ?  control                              :
                     (!pgfd_n && selected_reg && bus_addr == 8'h01 && rnw) ?  status                               :
                     (!pgfd_n && selected_reg && bus_addr == 8'h02 && rnw) ?  width_div_8                          :
                     (!pgfd_n && selected_reg && bus_addr == 8'h03 && rnw) ?  height_div_8                         :
                     (!pgfd_n && selected_reg && bus_addr == 8'h04 && rnw) ?  scaler_x_origin[7:0]                 :
                     (!pgfd_n && selected_reg && bus_addr == 8'h05 && rnw) ?  scaler_x_origin[10+SFB:8]            :
                     (!pgfd_n && selected_reg && bus_addr == 8'h06 && rnw) ?  scaler_y_origin[7:0]                 :
                     (!pgfd_n && selected_reg && bus_addr == 8'h07 && rnw) ?  scaler_y_origin[10+SFB:8]            :
                     (!pgfd_n && selected_reg && bus_addr == 8'h08 && rnw) ?  scaler_zoom                          :
                     (!pgfd_n && selected_reg && bus_addr == 8'h09 && rnw) ?  scaler_x_speed                       :
                     (!pgfd_n && selected_reg && bus_addr == 8'h0A && rnw) ?  scaler_y_speed                       :
                     (!pgfd_n && selected_reg && bus_addr == 8'h0B && rnw) ?  to_byte(STAGES - 1)                  :
                     (!pgfd_n && selected_reg && bus_addr == 8'h0C && rnw) ?  `MAGIC_LO                            :
                     (!pgfd_n && selected_reg && bus_addr == 8'h0D && rnw) ?  `MAGIC_HI                            :
                     (!pgfd_n && selected_reg && bus_addr == 8'h0E && rnw) ?  `VERSION_MIN                         :
                     (!pgfd_n && selected_reg && bus_addr == 8'h0F && rnw) ?  `VERSION_MAJ                         :
                     (!pgfd_n && selected_reg && bus_addr == 8'h10 && rnw) ?  gens[7:0]                            :
                     (!pgfd_n && selected_reg && bus_addr == 8'h11 && rnw) ?  gens[15:8]                           :
                     (!pgfd_n && selected_reg && bus_addr == 8'h12 && rnw) ?  gens[23:16]                          :
                     (!pgfd_n && selected_reg && bus_addr == 8'h13 && rnw) ?  gens[31:24]                          :
                     (!pgfd_n && selected_reg && bus_addr == 8'h14 && rnw) ?  cells[7:0]                           :
                     (!pgfd_n && selected_reg && bus_addr == 8'h15 && rnw) ?  cells[15:8]                          :
                     (!pgfd_n && selected_reg && bus_addr == 8'h16 && rnw) ?  cells[23:16]                         :
                     (!pgfd_n && selected_reg && bus_addr == 8'h17 && rnw) ?  cells[31:24]                         :
                     (!pgfd_n && selected_ram                      && rnw) ?  cpu_rd_data                          :
                     8'hZZ;

   assign bus_data_oel = !(
                           (clke && !pgfc_n &&             !rnw && (bus_addr == 8'hFF)) ||
                           (clke && !pgfc_n && selected && !rnw && (bus_addr == 8'hFE)) ||
                           (clke && !pgfc_n && selected && !rnw && (bus_addr == 8'hFD)) ||
                           (clke && !pgfd_n && selected_ram) ||
                           (clke && !pgfd_n && selected_reg));

   assign bus_data_dir = rnw;

   // =================================================
   // 1MHZ Bus FPGA Adapter Specific Stuff
   // =================================================

   assign irq          = 1'b0;
   assign nmi          = 1'b0;

   assign pmod0        = {blue , red};
   assign pmod1        = {2'b00, vsync ^ V_POL, hsync ^ H_POL, green};
   assign pmod2[7:4]   = 4'h0;
   assign pmod2[3:0]   = 4'hZ;

   assign led          = sw1 | sw2;

endmodule

// =================================================
// Life Pipeline (now byte wide with clock enable)
// =================================================

module life_pipeline
  (
   clk,
   clken,
   enabled,
   read_data,
   write_data
   );

   input clk;
   input clken;
   input enabled;
   input [7:0] read_data;
   output reg [7:0] write_data;

   // N = the number of cycles the pipeline is active for per line
   //     (this is currently NC + LPD + 1)
   //
   parameter    N = 0;

   // D internally is the length of the row delay element
   // The -3 is because of the 3 bytes in a,b,c
   localparam   D = (N-3)*8;

   reg [23:0]   a;
   reg [23:0]   b;
   reg [16:0]   c;
   wire [7:0]   d;

   reg [D-1:0]  row1;
   reg [D-1:0]  row2;

   genvar       i;

   generate
      for (i = 0; i < 8; i = i + 1) begin : b_cell
         life_cell c
               (.enabled(enabled),
                .top(a[i+9:i+7]),
                .middle(b[i+9:i+7]),
                .bottom(c[i+9:i+7]),
                .result(d[i]));
         end
   endgenerate

   always @(posedge clk)
     if (clken) begin
        a          <= {a[15:0], read_data};
        row1       <= {row1[D-9:0], a[23:16]};
        b          <= {b[15:0], row1[D-1:D-8]};
        row2       <= {row2[D-9:0], b[23:16]};
        c          <= {c[8:0], row2[D-1:D-8]};
        write_data <= d;
     end

endmodule

module life_cell
  (
   enabled,
   top,
   middle,
   bottom,
   result
   );
   input enabled;
   input [2:0] top;
   input [2:0] middle;
   input [2:0] bottom;
   output result;

   function [2:0] partial_sum;
      input [3:0] partial;
      case (partial)
        // 1-cell
        4'b0001 : partial_sum = 3'b001;
        4'b0010 : partial_sum = 3'b001;
        4'b0100 : partial_sum = 3'b001;
        4'b1000 : partial_sum = 3'b001;
        // 2-cells
        4'b1100 : partial_sum = 3'b010;
        4'b1001 : partial_sum = 3'b010;
        4'b0011 : partial_sum = 3'b010;
        4'b0110 : partial_sum = 3'b010;
        4'b0101 : partial_sum = 3'b010;
        4'b1010 : partial_sum = 3'b010;
        // 3-cells
        4'b1110 : partial_sum = 3'b011;
        4'b1101 : partial_sum = 3'b011;
        4'b1011 : partial_sum = 3'b011;
        4'b0111 : partial_sum = 3'b011;
        // 4-cells
        4'b1111 : partial_sum = 3'b100;
        // 0 cells
        default : partial_sum = 3'b000;
      endcase
   endfunction

   wire [2:0] p1 = partial_sum({   top, middle[2]});
   wire [2:0] p2 = partial_sum({bottom, middle[0]});
   wire [3:0] sum = p1 + p2;

   assign result = (sum == 2 || !enabled) ? middle[1] :
                   (sum == 3            ) ? 1'b1      :
                   1'b0 ;
endmodule
