hoglet67/Beeb1MHzBusFpga/life/assembler/atom_constants.asm

base_fred       = &B600

base_jim        = &B700

godil           = &BDE0

base_zp         = &70

OSFIND_ATOM     = &FFCE
OSSHUT_ATOM     = &FFCB

OSBGET          = &FFD4
OSASCI          = &FFE9
OSNEWL          = &FFED
OSWRCH          = &FFF4
OSCLI           = &FFF7

WRCVEC          = &0208

osfind_block    = &90
last_key        = &92
file_count      = &93
file_base       = &94
file_ptr        = &95
file_state      = &96
