hoglet67/Beeb1MHzBusFpga/life/assembler/beeb_constants.asm

base_fred       = &FC00

base_jim        = &FD00

base_zp         = &70

OSFIND          = &FFCE
OSGBPB          = &FFD1
OSBGET          = &FFD7
OSRDCH          = &FFE0
OSASCI          = &FFE3
OSNEWL          = &FFE7
OSWRCH          = &FFEE
OSWORD          = &FFF1
OSBYTE          = &FFF4
OSCLI           = &FFF7
