hoglet67/Beeb1MHzBusFpga/(commit log)

2019-03-01 Added v1 of 1MHz Bus FPGA Adapter PCB
    [Music5000.kicad_pcb, Music5000.sch]
2019-03-05 PCB: Added switches
    [Music5000.kicad_pcb, Music5000.sch]
2019-03-05 PCB: Added manufacturing data
    [Music5000.gbl, Music5000.gbo, Music5000.gbs, Music5000.gko, Music5000.gtl, Music5000.gto, Music5000.gts, Music5000.xln]
2019-03-07 PCB: Renamed project from Music5000 to BusAdapter
    [BusAdapter.kicad_pcb, BusAdapter.sch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]
2019-04-01 PCB v2: Initial check-in
    [BusAdapter.kicad_pcb, BusAdapter.sch]
2019-04-01 PCB v2: Added pmod2 and updated layout
    [BusAdapter.kicad_pcb, BusAdapter.sch]
2019-04-01 PCB v2: Updated SW1/2 to HSWAPEN pulled low on power up
    [BusAdapter.kicad_pcb, BusAdapter.sch]
2019-04-01 PCB v2: Improved SRAM decoupling
    [BusAdapter.kicad_pcb, BusAdapter.sch]
2019-04-01 PCB v2: Improved SRAM decoupling even more
    [BusAdapter.kicad_pcb]
2019-04-02 PCB v2: Enlarged IDC connector holes; added power connector
    [BusAdapter.kicad_pcb, BusAdapter.sch]
2019-04-02 PCB v2: Made TSOP-II pads 0.5mm longer on the outside
    [BusAdapter.kicad_pcb, BusAdapter.sch]
2019-04-13 PCB v2: Refreshed design in KiCad 5.0.2-stable
    [BusAdapter.kicad_pcb]
2019-04-13 PCB v2: Solder Mask Clearance/Width = 0.15mm/0.40mm
    [BusAdapter.kicad_pcb]
2019-04-13 PCB v2: Added manufacturing files
    [BusAdapter.gbl, BusAdapter.gbo, BusAdapter.gbs, BusAdapter.gko, BusAdapter.gtl, BusAdapter.gto, BusAdapter.gts, BusAdapter.xln]
2019-04-13 PCB v2: Corrected error with orientation of power connector
    [BusAdapter.kicad_pcb]
2019-04-13 PCB v2: Updated manufacturing files
    [BusAdapter.gbl, BusAdapter.gbo, BusAdapter.gbs, BusAdapter.gko, BusAdapter.gtl, BusAdapter.gto, BusAdapter.gts, BusAdapter.xln]
2019-05-03 Corrected SRAM part number on schematic
    [BusAdapter.sch]
2019-05-03 Corrected RN and LED values on schematic
    [BusAdapter.sch]
2020-02-12 Frame Buffer: initial commit
2020-03-29 Frame Buffer: added initial release
2020-04-07 Frame Buffer: .xise churn
2020-04-07 Frame Buffer: initial version of blitter
2020-04-07 Frame Buffer: added fill_op
2020-04-07 Frame Buffer: added char_op
2020-04-08 Frame Buffer: Also create .bin file
2020-04-08 Frame Buffer: added v2 release for Ed to test
2020-04-08 Frame Buffer: Simple OSWRCH implementation
2020-04-08 Frame Buffer: Optimize write-only ops (now 25M pixels/sec)
2020-04-08 Frame Buffer: use ODDR I/O fir driving external SRAM
2020-04-08 Frame Buffer: fix yellow tint (Ed was right!)
    [frame_buffer.vhd]
2020-04-09 Frame Buffer: work around a bug when scrolling
    [frame_buffer.vhd]
2020-04-09 Frame Buffer: Optimised OSWRCH character output
2020-04-09 Frame Buffer: Changed OSWRCH to use cursor_x,cursor_y
2020-04-09 Frame Buffer: Copy now: D = (S and mask) | (D and not mask)
2020-04-10 Frame Buffer: Added Palette
2020-04-10 Frame Buffer: Prisma 3 256-col RLE Image Reader
2020-04-10 Frame Buffer: Prisma 3 reader improvements
2020-04-10 Frame Buffer: Play nicely with other devices sharing the 1MHz Bus
2020-05-15 Life: Correct pipelining of video control signals
    [life.v]
2020-05-15 Life: fix a bug with masking
    [life.v]
2020-05-15 Life: support readback of frame buffer, and fix all warnings
    [life.v]
2020-05-15 Life: change running only at start of frame
2020-05-16 Life: fix bug in name parsing
    [rle_utils.asm]
2020-05-16 Life: Switch menu to MODE 0; add author
2020-05-20 Life: fix left edge scaler anomaly
    [life.v]
2020-05-20 Life: scaler correctly wraps across edges (thanks Ed)
    [life.v, loader.asm]
2020-05-20 Life: added hardware pan velocity registers
2020-05-20 Life: added fractional velocities
2020-05-20 Life: fix F0 for edge mode toggle
    [loader.asm]
2020-05-20 Life: minor discontinuity fix when pixel-pair straddles boundary
    [life.v]
2020-05-20 Life: fudge 2 cell alignement issue
    [life.v]
2020-05-22 Life: Really fix boundary condition bug (doh!)
    [life.v]
2020-05-22 Life: load patterns at current origin, fix wrapping bugs
    [loader.asm, rle_reader_fpga.asm]
2020-05-22 Life: Reverse the controls
    [loader.asm]
2020-05-22 Life: fix issue where single step sometimes stepped twice
    [loader.asm]
2020-05-22 Life: run clear_screen for two frames, to make sure the shift regs are flushed
2020-05-24 Life: add double buffering (plus slight rework of timing)
    [life.v]
2020-05-24 Life: scaler: fix stepping in overlaid boundaries
    [life.v]
2020-05-25 Life: fix broken 'Not Found' error
    [constants.asm, indexer.asm, rle_utils.asm]
2020-05-25 Life: correctly wrap both X and Y coordinates when loading
    [constants.asm, rle_reader_fpga.asm]
2020-05-25 Life: update scaler to wrap lines correctly (almost)
    [life.v]
2020-05-26 Life: fix scaler issue around the l/r boundary at odd pixel offsets
    [life.v]
2020-05-26 Life: fix issue when scaler windows wraps by exactly 1px
    [life.v]
2020-05-27 Life: Cleaner implementation of (upto) 8 stage pipeline
2020-05-27 Life: fix bondary discontinuity at speeds > 1x
    [life.v]
2020-05-27 Life: minor cursor positioning error
    [loader.asm]
2020-05-28 Life: Increase the pipeline to 10 stages
2020-05-28 Life: Allow for two DCMs to be chained
2020-05-28 Life: fix a bug with panning introduced by the register changes
    [loader.asm]
2020-05-30 Life: reduce 1920x1080 to 6 stages
2020-05-31 Life: add 1920x1200, update 1280x768, correct sync polarity
    [life.v, resolutions.v]
2020-06-01 Life: fix a scaler wrapping bug at 1920 wide
    [life.v]
2020-06-01 Life: fix origin issue at max speed by preloading one more line
    [life.v]
2020-06-02 Life: fix an indexer bug when switching disks
    [indexer.asm]
