hoglet67/Beeb1MHzBusFpga/(notices)

Notices in the files:
kicad/v2/BusAdapter.kicad_pcb:
© 2019 Hoglet
